jfruitet/RoBoNav/RoBoNav_Smartphone/Application MIT/Telecommande/assets/rc_right_2.png

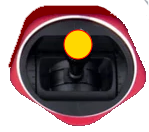
RoBoNav_Smartphone/Application MIT/Telecommande/assets/rc_right_2.png
