jfruitet/RoBoNav/RoBoNav_Smartphone/Application MIT/Telecommande/assets/rc_background.png

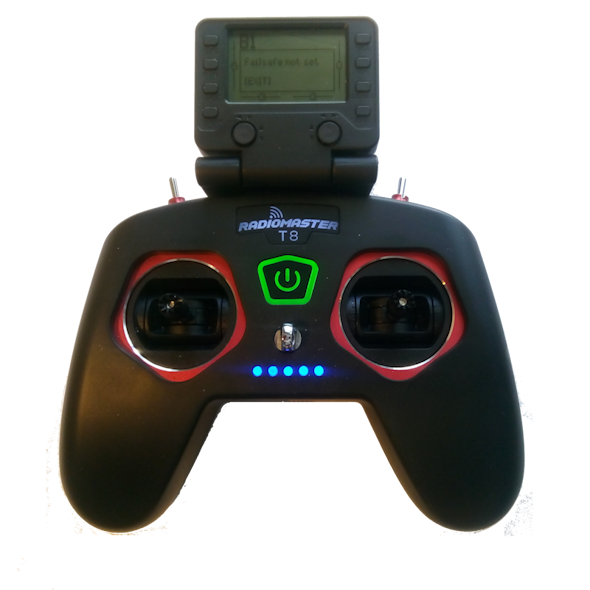
RoBoNav_Smartphone/Application MIT/Telecommande/assets/rc_background.png
