jfruitet/RoBoNav/RoBoNav_2025/README.md

# RoboNav

## Projet RoBoNav - 2025

Contributions de Agathe DAUDENTHUN <agathe.daudenthun@2026.icam.fr> et Thed KAMGA thed.kamga@2026.icam.fr de l'ICAM de Nantes

Contact : jean.fruitet@free.fr

## Présentation
En 2025 l'équipe de l'ICAM s'est consacrée à l'amélioration du positionnement GPS.

Différents GPS ont été utilisés, des GPS d'entrée de gamme UBlox M8N aux GPS Quectel RTK.
Des comparatifs de précision ont été effectués.

### RTK
Real Time Kinetic est un protocole permettant d'acquérir des données GPS de haute précision (de l'ordre du cm) 
La mise en oeuvre et une liste de matériel est disponible sur le site du réseau Centipede https://docs.centipede.fr/

Pour des raisons de coût nous nous sommes tournés vers des modules GPS Quectel de haute précision. 
Mais ce n'est qu'au mois de juillet 2025 que nous avons réussi à accéder à une précision centimétrique.

C'est l'équipe de développement 2025 - 2026 qui prendra en charge l'intégration au projet RoBoNav.

Pour accéder aux travaux concernant les GPS consulter le Github https://github.com/jfruitet/GPS
