jfruitet/RoBoNav/RoBoNav_Smartphone/Application MIT/MIT APP Inventor.docx

# APP MIT Inventor:

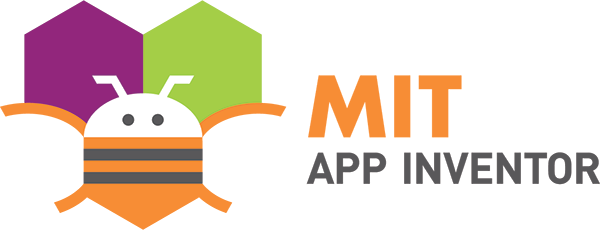
[picture p8: figure]

I. Introduction à MIT App inventor: 3

II. Mise en ligne d’une application MIT app inventor: 3

III. Page d'accueil 3

A. Screen 3

B. Blocs 4

IV. Télécommande 4

A. Screen: 4

B. Blocs: 5

1. Bloc d’initialisation: 5

2. Changement de l’adresse IP de la bouée: 6

3. Ajout du numéro de bouée à la fin de l’adresse IP, en fonction du choix de bouée 7

4. Contrôler l’envoie des données: 7

5. Envoie des blocs de caractères correspondant aux voies de la bouée: 7

6. Envoie des blocs de caractères correspondant au “Bouton ON” de la bouée: 8

7. Récupération des données du joystick et mise à l’échelle des valeurs: 9

8. Modélisation des switchs de la télécommande: 9

9. Récupération des données de la voies 1 à 4: 10

V. Map 12

A. Screen: 12

B. Blocs: 12

1. Initialisation des paramètres 13

2. Création d’un point GPS cible sur la carte: 13

3. Suppression d’un marqueur cible: 14

4. Gestion de l’adressage IP de la bouée: 15

5. Envoi du train de caractère pour récupérer le numéro de bouée et les coordonnées GPS de la bouée: 16

# I. Introduction à MIT App inventor:

Afin d’avoir une interface homme-machine, nous avons choisi de travailler avec MIT APP inventor, qui permet de créer de façon intuitive et efficace une application.

Voici le lien permettant de créer une application Androïd gratuitement et en ligne:

https://appinventor.mit.edu/

Cette application à un rôle de capteur. C’est à dire que lorsqu'un ordre à la bouée est donnée sous la forme d’une interaction avec l’application, l’application envoie à la bouée des “Blockchain” ou un train de chaîne de caractère à la bouée. Le traitement de ces informations se fait ensuite directement à travers la carte Arduino afin de transformer les ordres en action réalisé par la bouée.

Pour reconnaître quel type d’ordre provient de la bouée, nous avons mis des “mots clés”, en début de chaîne, ce qui nous permettra de repérer le type de chaîne envoyée.

# II. Mise en ligne d’une application MIT app inventor:

Vous retrouverez l'ensemble de la procédure de mise en ligne de l’application Androïd sur le lien suivant: https://fr.yeeply.com/blog/publier-application-google-play-store/

Pour résumer les étapes, il faut:

1. Créer une compte développeur sur google play (coût unique de 25 USD)
2. cliquer sur “toutes les applications” puis “créer une application”
3. Créer et remplir une liste Play Stores (avec les informations que les utilisateurs verront)
4. Télécharger le document apk de l’application et choisir le type de publication (test interne, fermé, ou ouvert)
5. Définir la classification du contenu de l’application (primordial car si non classifié, l’application pourrait être retiré)
6. Définir le prix et la distribution de votre application
7. Soumettre l’application à un examen (il faut attendre un contrôle vert sur chaque section)
8. Attendre que la version de déploiement soit disponible (cela peut prendre quelques jours)

# III. Page d'accueil

La page d’accueil a plus une fonction graphique que de commande de la bouée. Elle permet de présenter l’application et les personnes partenaires de l’application. Elle permet également de faire le lien avec la page où se trouve la télécommande et la page où se trouve la carte.

## A. Screen

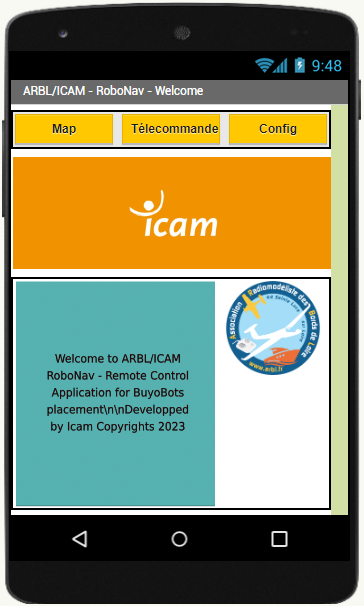
[picture p9: figure]

Btn_Config

Btn_Map

Btn_Télécommande

## B. Blocs

Cette fenêtre n’ayant pas beaucoup de fonctionnalités, peut de blocs y sont associés. Seuls les blocs de changement de screen existent. La screen 2 correspond à la page map.

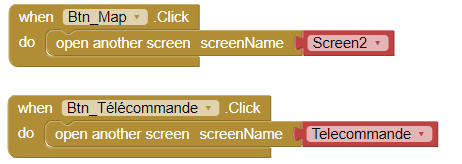
[picture p10: figure]

# IV. Télécommande

## A. Screen:

Voici à quoi ressemble l’interface de l’application sur l'écran télécommande. En légende sont inscrites toutes les appellations utilisées dans la partie des blocs.

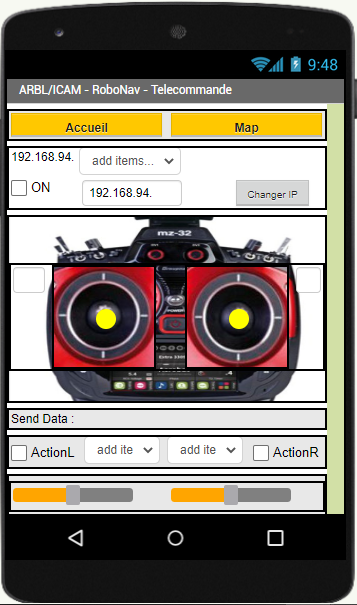
[picture p11: figure]

Btn_Map

Btn_Changer_IP

Btn_Accueil

Lbl_IP_bouee

Btn_ON

Txt_Box-New_IP

Spinner_IP_Bouee

Joy_Right

Joy_Left

Lbl_Send_Data

Lbl_UDP_Data

Action_L

Mode_L

Action_R

Mode_R

Voie3 & Voie4

Voie1 & Voie2

## B. Blocs:

### 1. Bloc d’initialisation:

Ce bloc à pour objectif d’initialiser toutes les variables lors du lancement de l’application, ou lors de l’ouverture de nouvelle fenêtre.

Tout d’abord nous initialisons toutes les variables globales:

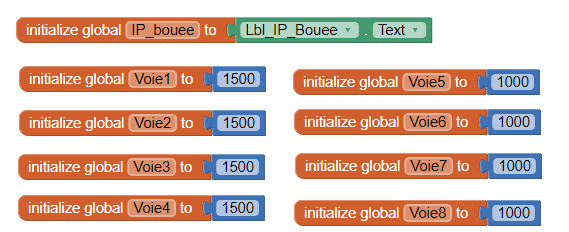
[picture p12: figure]

Chaque voie correspond à une voie physique d’une télécommande classique.

Puis nous initialisons les variables lié à la télécommande:

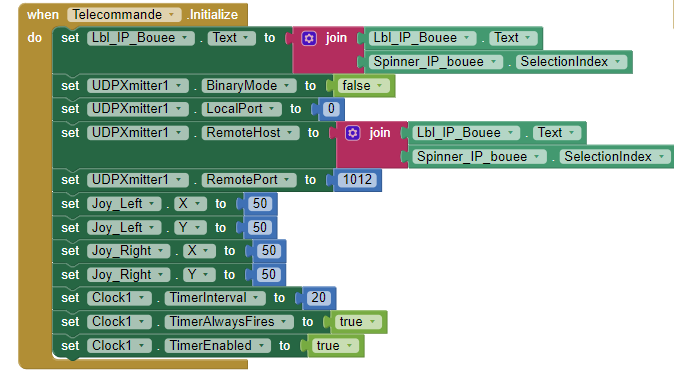
[picture p13: figure]

Initialisation du label de la bouée

Initialisation de L’UDPXmitter1 qui permet la transmission d’information de l’app vers la bouée

Initialisation des joysticks présents sur la télécommande

initialisation du timer permettant de contrôler la fréquence d'envoi des données

### 2. Changement de l’adresse IP de la bouée:

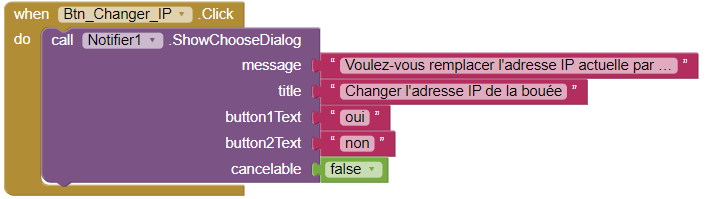
[picture p14: figure]

Lorsque l’on clique sur le bouton changer IP, alors un pop-up apparaît avec le texte du title et du message ainsi que 2 boutons: “oui”, “non”

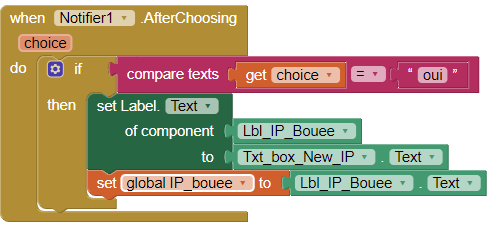
[picture p15: figure]

Si l’utilisateur choisit le cliqué sur oui, alors le bloc suivant permet de rentrer et dans le label et dans la variable IP_bouee la nouvelle adresse IP (texte qui était noté dans la Texte Box “Txt_box_Nex_IP”.

### 3. Ajout du numéro de bouée à la fin de l’adresse IP, en fonction du choix de bouée

Ce bloc permet que lorsque l’on change le numéro de bouée choisit dans le spinner, le numéro choisi vient s’ajouter à l’adresse IP préexistant.

!! Pour le moment les chiffres ne viennent pas se remplacer mais s’ajouter. Ainsi pour changer de numéro de bouée, il faut d’abord changer l’IP grâce au bouton, puis choisir le numéro de bouée.

### 4. Contrôler l’envoie des données:

Afin de contrôler l’envoie des données, et éviter la saturation des informations envoyées à la carte de programmation lors de l’utilisation de la télécommande présente sur l’application, nous avons utilisé une horloge (ou clock)

Voici le bloc associé à cette fonction:

### 5. Envoie des blocs de caractères correspondant aux voies de la bouée:

Pour pouvoir faire le lien entre l’application et la bouée, nous envoyons des trains de données grâce au protocole UDP.

Pour récupérer les données concernant RC1 (le mode 4 voies), voici le bloc utilisé:

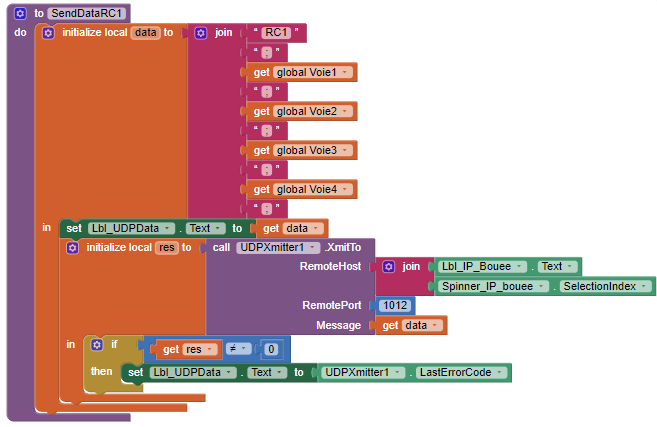
[picture p16: figure]

Le train de caractère commencera par RC1, afin que l’on puisse identifier sa source. Le séparateur choisis entre les différentes informations est un “:”. Seront mises en séries toutes les valeurs récupérés des voies 1 à 4.

Cette partie permet l’envoie des données selon le protocole UDP à l’IP de la bouée

De même, nous avons construit le même type de bloc pour RC2, mais cette fois-ci avec non pas 4 voies dans le haut du bloc, mais 8 voies.

### 6. Envoie des blocs de caractères correspondant au “Bouton ON” de la bouée:

Ces blocs correspondent à l’appelle de la fonction “SendDataON” lorsque le bouton est coché et décoché. Lorsque celui-ci est cohé, on attribue la valeur “true” à la variable globale “btn_ON_value”, et lorsque celui-ci est décocher, la valeur false.

La fonction “SendDataON” correspond à l’envoi du train de caractère à la carte programmable:

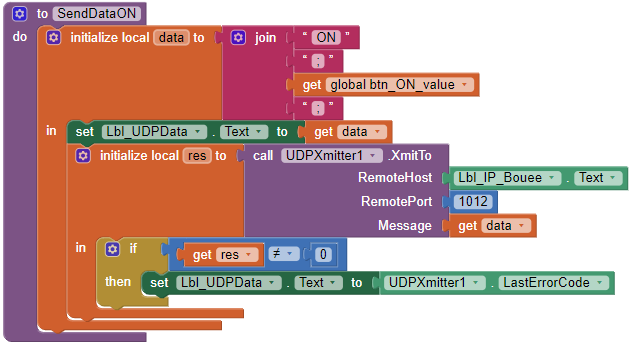
[picture p17: figure]

### 7. Récupération des données du joystick et mise à l’échelle des valeurs:

Les blocs ci-dessous correspondent aux blocs permettant de modéliser les joysticks de la télécommande. Vous ne trouverez que ceux pour le joystick de gauche. Cependant il existe exactement le même bloc pour le joystick droit.

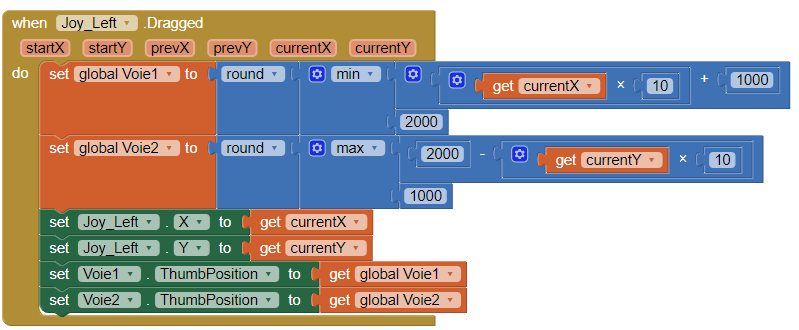
[picture p18: figure]
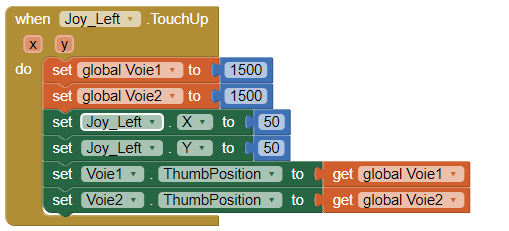
[picture p19: figure]

### 8. Modélisation des switchs de la télécommande:

Afin de modéliser les huits voies le la télécommande, nous avons rajouté des boutons “Action L” et “Action R” pour modéliser les switchs 2 positions, ainsi que des spinners “Mode L” et “Mode R” pour modéliser les switchs trois positions.

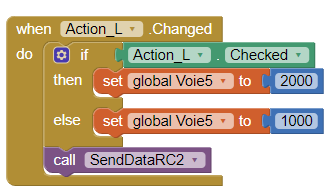
[picture p20: figure]

Bloc permettant que lorsque le Action_L est sélectionné, une valeur de 2000 est renvoyée sur la voie 5

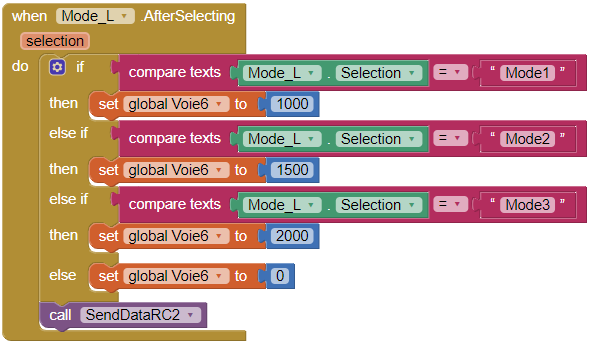
[picture p21: figure]

Ce bloc permet qu’en fonction de la sélection (Mode 1, 2, 3), les valeurs renvoyées sur la voie 6 soient différentes

### 9. Récupération des données de la voies 1 à 4:

Le rôle de l’application est de capter les ordres réalisés sur l'écran et de les transmettre à la bouée. Pour cela nous utilisons un protocole UDP, et envoyons les valeurs récupérées sur chaque vois sous forme d’un train de caractère. Voici le bloc permettant cet envoi.

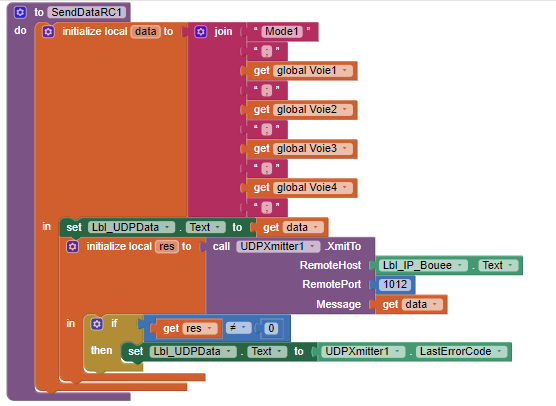
[picture p22: figure]

Formalisme d’envoi des données, avec pour séparateur de chaque donnée de chaque voie: un “;”

Protocole UDP d’envoi des données à la carte arduino par Wifi

10. Récupération des données de la voie 1 à 8:

Pour la récupération des 8 voies d’un seul coup, nous avons réalisé le même type de bloc que dans la partie ci-dessus, en ajoutant simplement les voies de 5 à 8 dans la première partie du bloc. Voici la partie concernée par le changement dans le bloc.

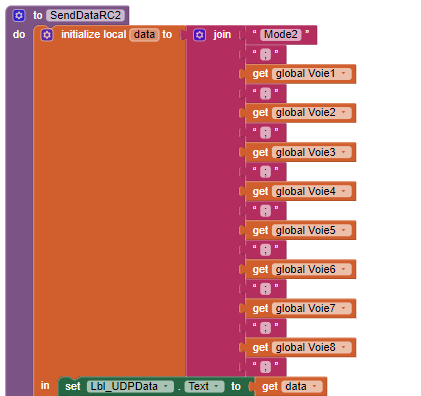
[picture p23: figure]

# V. Map

## A. Screen:

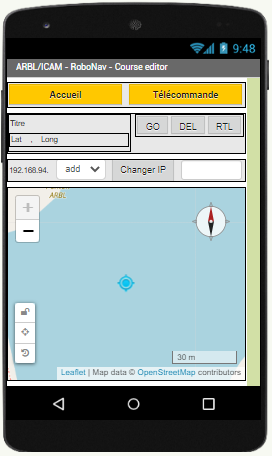
[picture p24: figure]

Btn_GO

Btn_DEL

BtnRTL

Btn_Télécommande

Btn_Accueil

Lbl_Cible

Lbl_Lat

Lbl_point

Lbl_Long

Lbl_IP_bouee

Spinner_IP_bouee

Btn_Changer_IP

Txt_Box_New_IP

Map_Zone

## B. Blocs:

### 1. Initialisation des paramètres

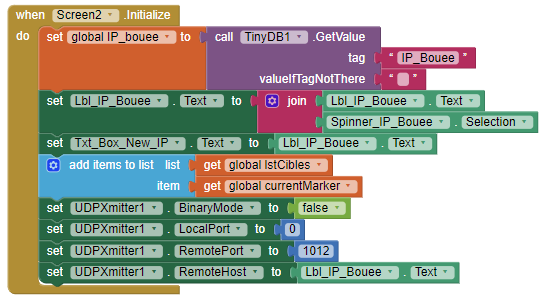
[picture p25: figure]

### 2. Création d’un point GPS cible sur la carte:

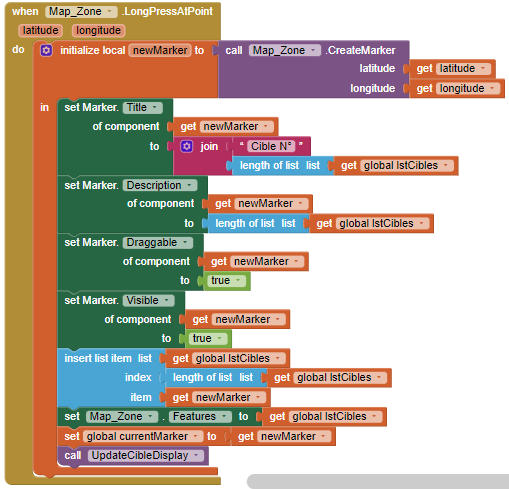
[picture p26: figure]

Création du marker

Association des paramètres (GPS et n° de bouée) au nouveau marker créé

Incrémentation du numéro de bouée en fonction du nombre de cible déjà créés

Ce bloc fait appel, à la fin, à la fonction “UpdateCibleDisplay”. La fonction est détaillée ci-dessous. Cette fonction permet de mettre à jour l’affichage des données concernant le numéro de cible, et les coordonnées GPS du marquer créé.

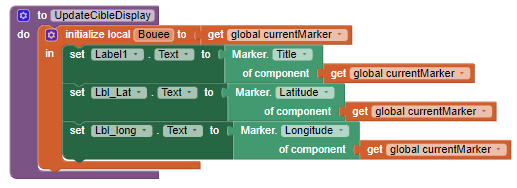
[picture p27: figure]

### 3. Suppression d’un marqueur cible:

Ce bloc permet que lorsque l’on appuis sur le bouton “DEL”, le marqueur sélectionné à ce moment-là est supprimé, et les données associées également.

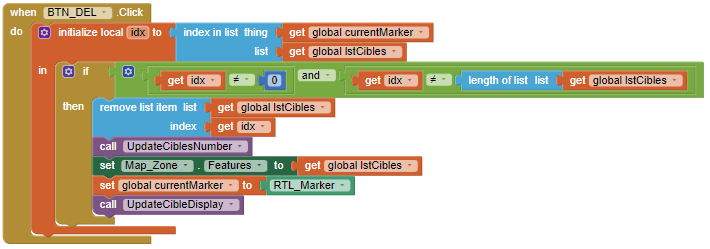
[picture p28: figure]

Ce bloc fait appelle à deux fonctions:

- UpdateCibleDisplay (déjà présenté ci-dessus)
- UdateCiblesNumber

Cette deuxième fonction permet d’ajouter un numéro de bouée, et donc une nouvelle cible dans la liste des bouées:

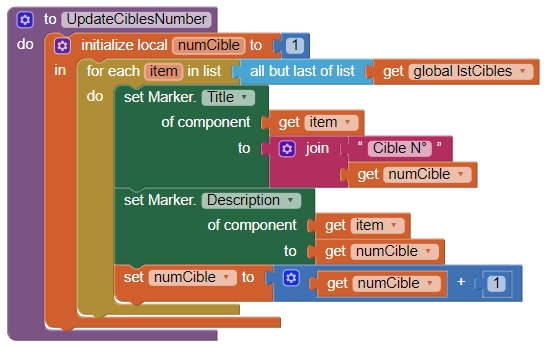
[picture p29: figure]

### 4. Gestion de l’adressage IP de la bouée:

Pour le changement d’adresse IP, nous avons procédé de la même manière que pour la télécommande, voici donc les blocs concernés:

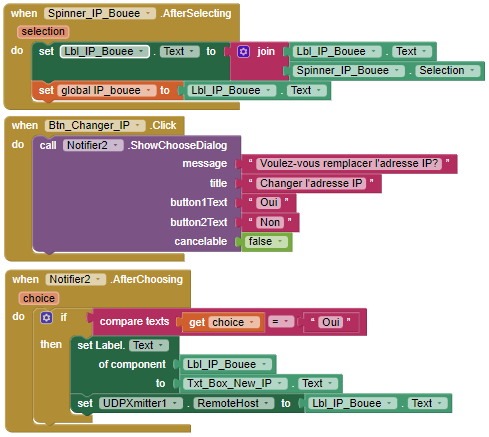
[picture p30: figure]

### 5. Envoi du train de caractère pour récupérer le numéro de bouée et les coordonnées GPS de la bouée:

Pour la réalisation la de l’envoi de train de caractère permettant de récupérer pour une bouée donnée les coordonnées (longitude et latitude) visés, nous avons utilisé deux blocs différents.

Tout d’abord nous avons fabriqué la fonction permettant de créer le train de caractère que nous souhaitons envoyer. Nous avons choisi le mot “GPS” comme mot repère du bloc, qui nous permettra ainsi d’identifier la réception d’un bloc possédant les coordonnées visées de la bouée lors du traitement des blocs dans la partie Arduino.

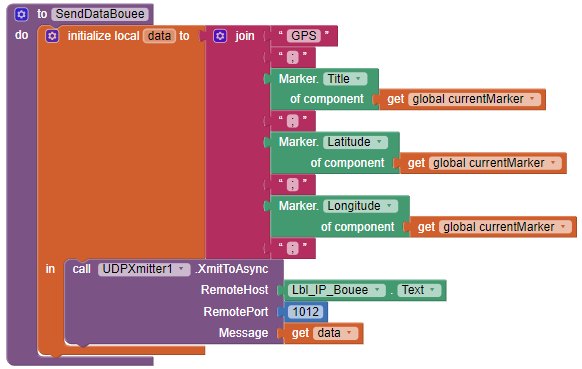
[picture p31: figure]

Partie concernant la création du train de caractère, séparé par des “;”

Liaison avec la bouée par un protocole UDP

Puis nous avons réalisé les conditions d’appel de la fonction:

Lorsque le Bouton Go est cliqué, alors les coordonnées de la cible sélectionnée sont envoyées au récepteur wifi arduino.

FREMY Enora et LOUVET Marie
