jfruitet/RoBoNav/RoBoNav_PCB/dimensions PCB.jpg

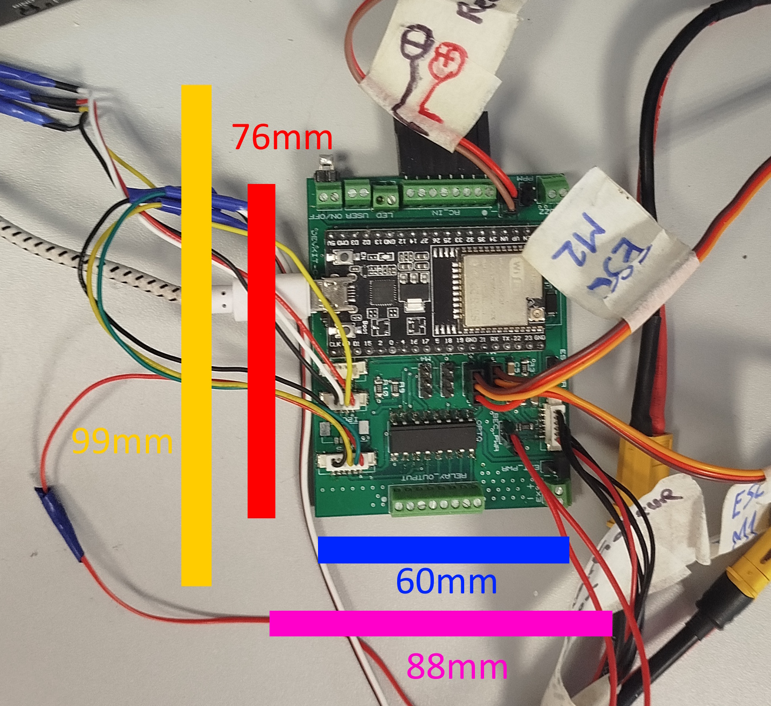
RoBoNav_PCB/dimensions PCB.jpg
