jfruitet/RoBoNav/RoBoNav_PCB/Schematic_Board_v0.7.png

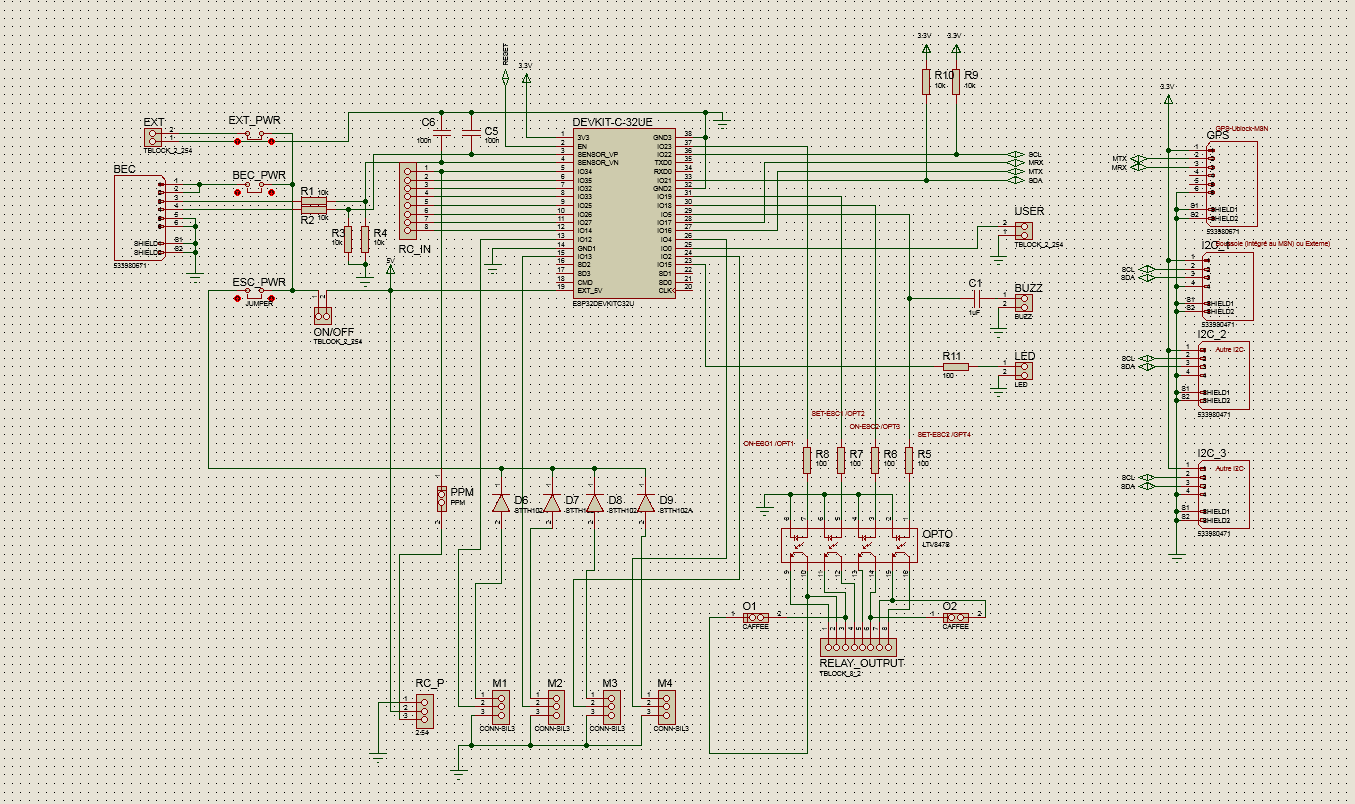
RoBoNav_PCB/Schematic_Board_v0.7.png
