jfruitet/RoBoNav/RoBoNav_Smartphone/Application MIT/Telecommande/assets/AccueilMap.png

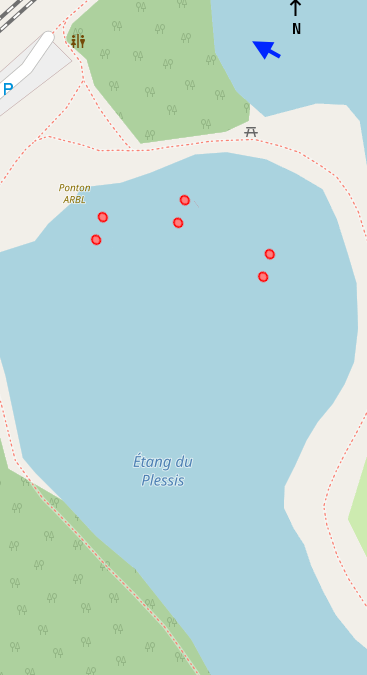
RoBoNav_Smartphone/Application MIT/Telecommande/assets/AccueilMap.png
