jfruitet/RoBoNav/RoBoNav_Smartphone/Application MIT/Telecommande/assets/ICAM.jpg

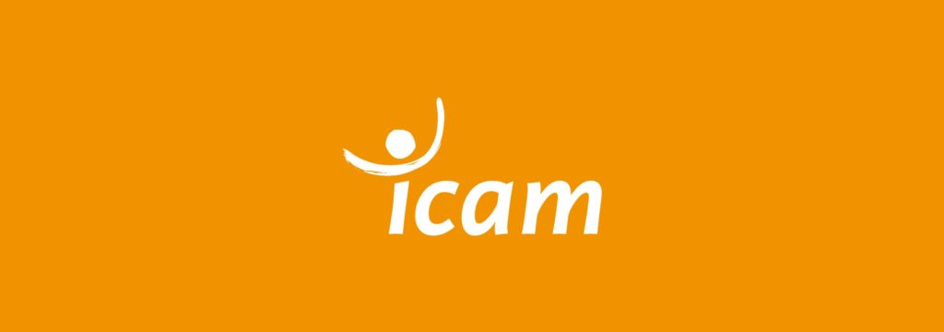
RoBoNav_Smartphone/Application MIT/Telecommande/assets/ICAM.jpg
