jfruitet/RoBoNav/RoBoNav_Smartphone/Application MIT/Telecommande/assets/ICAM.png

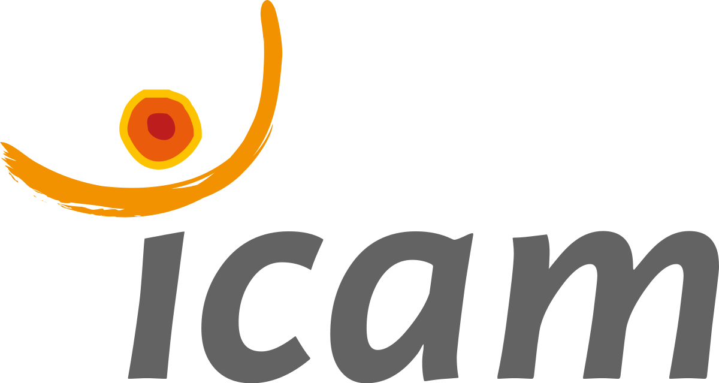
RoBoNav_Smartphone/Application MIT/Telecommande/assets/ICAM.png
