jfruitet/RoBoNav/RoBoNav_Smartphone/Application MIT/Telecommande/assets/IMG_20230528_100340.jpg

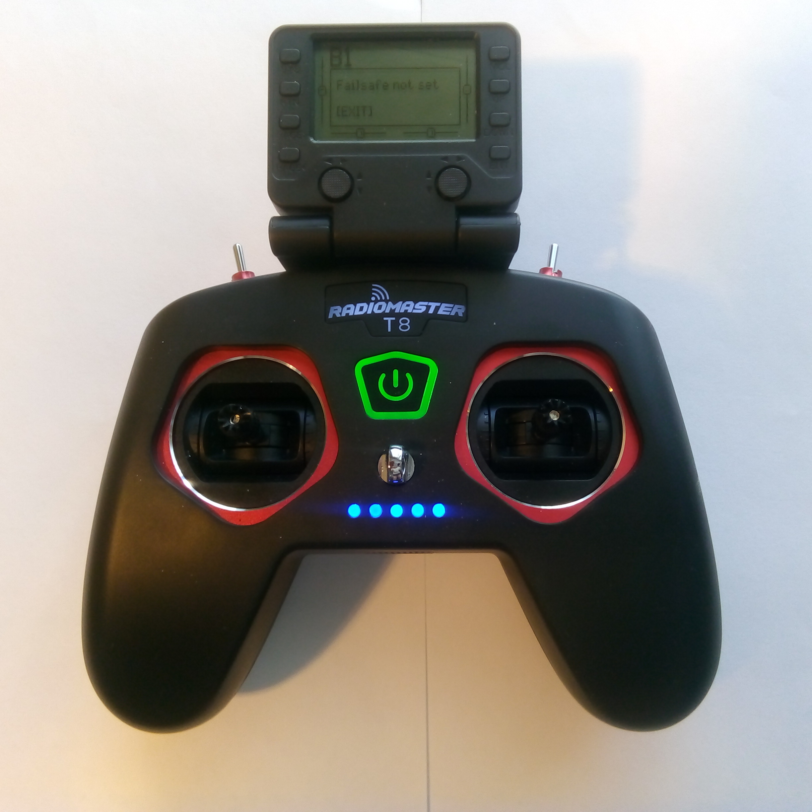
RoBoNav_Smartphone/Application MIT/Telecommande/assets/IMG_20230528_100340.jpg
