jfruitet/RoBoNav/RoBoNav_Smartphone/Application MIT/Telecommande/assets/Messageacceuil.PNG

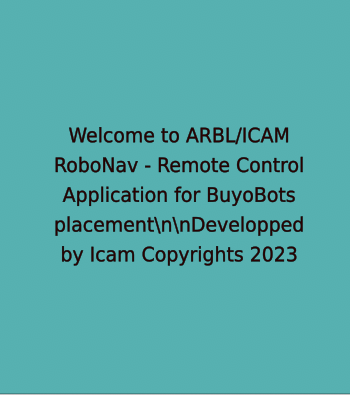
RoBoNav_Smartphone/Application MIT/Telecommande/assets/Messageacceuil.PNG
