jfruitet/RoBoNav/RoBoNav_Smartphone/Application MIT/Telecommande/assets/Messageaccueil.png

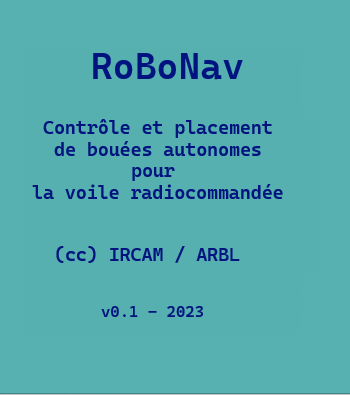
RoBoNav_Smartphone/Application MIT/Telecommande/assets/Messageaccueil.png
