jfruitet/RoBoNav/RoBoNav_Smartphone/Application MIT/Telecommande/assets/rc_background.jpg

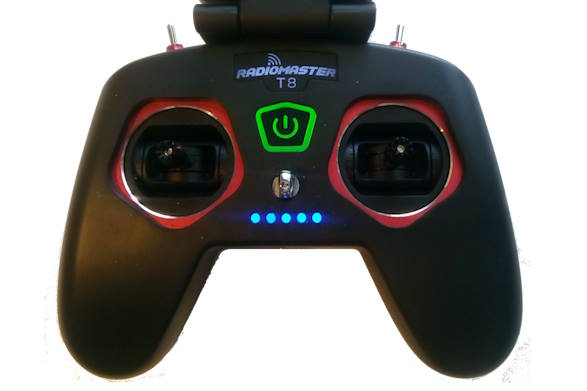
RoBoNav_Smartphone/Application MIT/Telecommande/assets/rc_background.jpg
