jfruitet/RoBoNav/RoBoNav_Smartphone/Application MIT/Telecommande/assets/rc_background_graupner.jpg

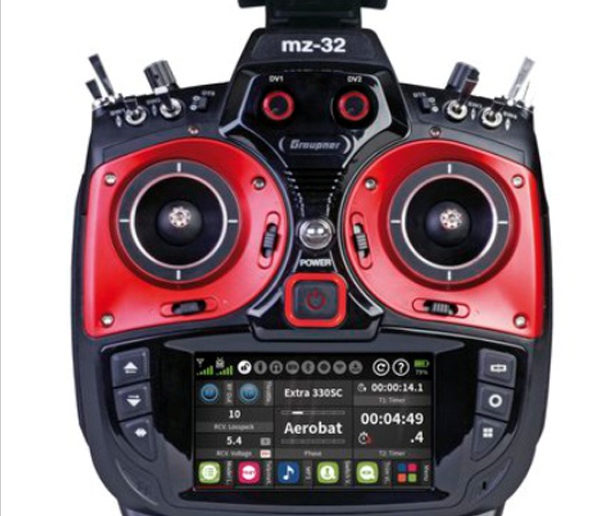
RoBoNav_Smartphone/Application MIT/Telecommande/assets/rc_background_graupner.jpg
