jfruitet/RoBoNav/RoBoNav_Smartphone/Application MIT/Telecommande/assets/rc_left_2.png

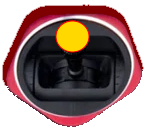
RoBoNav_Smartphone/Application MIT/Telecommande/assets/rc_left_2.png
