jfruitet/RoBoNav/RoBoNav_Smartphone/Application MIT/Telecommande/assets/rc_left_graupner.png

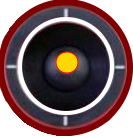
RoBoNav_Smartphone/Application MIT/Telecommande/assets/rc_left_graupner.png
