jfruitet/RoBoNav/RoBoNav_Smartphone/Application MIT/Telecommande/assets/Test/Accueil_simulateur.png

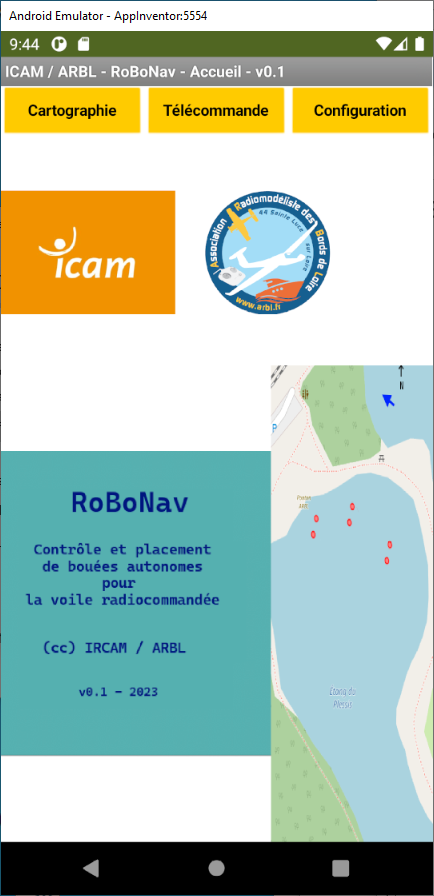
RoBoNav_Smartphone/Application MIT/Telecommande/assets/Test/Accueil_simulateur.png
