jfruitet/RoBoNav/RoBoNav_PCB/RoboNav7_PCB_Schema_cablage.PDF

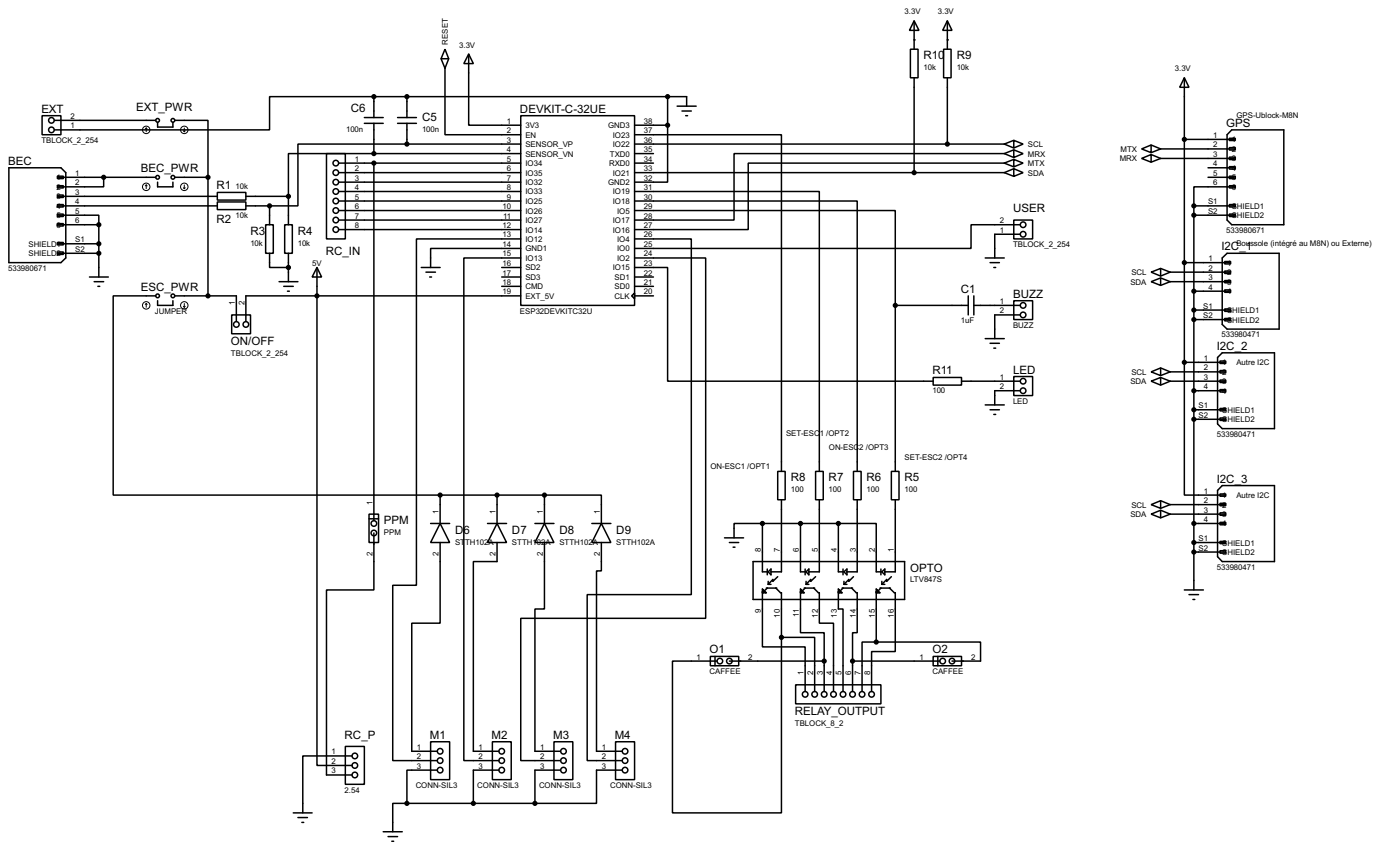
[picture p73: page 1]

33
32

30
29
28
27
26

14 | | 25
15 | | 24
