jfruitet/RoBoNav/(list of files, drawings)

Other design files:
RoBoNav_PCB/RobotNav7.pdsprj
RoBoNav_PCB/RobotNav.pdsprj
