jfruitet/RoBoNav/RoBoNav_ESP32/src/RoBoNav_config_WiFi.h

/*******************************************
RoBoNav  2023 - 2024 - RoBoNav_config_WiFi.h 

********************************************/

#ifndef RoBoNav_config_WiFi_H
#define RoBoNav_config_WiFi_H

//--- WiFi Access Point Configuration ---//
const char *ssid = "NicoPhone";
const char *password = "12345678";

#endif
