jfruitet/RoBoNav/r4_BLE_UART_CommandeDirection/flechesdirection2.h

#define leftDir  3
#define rightDir  2
#define upDir  1
#define downDir  0
#define questionDir  4

const uint32_t flechesdirection2[][4] = {
	{
		0x4004004,
		0x401f00,
		0xe0040000,
		66
	},
	{
		0x400e,
		0x1f00400,
		0x40040040,
		66
	},
	{
		0x1001,
		0x81fc0180,
		0x10000000,
		66
	},
	{
		0x400c,
		0x1fc0c00,
		0x40000000,
		66
	},
	{
		0xe011,
		0x1100600,
		0x40000040,
		66
	}
};
