jfruitet/RoBoNav/(commit log)

2024-07-18 Schémas du circuit imprimé et brochage pour ESP32-WROOM
    [RobotNav [20240314, 16-56-37].pdsprj, RobotNav [20240314, 16-57-49].pdsprj, RobotNav [20240314, 16-59-04].pdsprj, RobotNav [20240314, 16-59-47].pdsprj, RobotNav [20240314, 17-01-59].pdsprj, RobotNav [20240314, 17-02-48].pdsprj, RobotNav [20240314, 17-03-42].pdsprj, RobotNav [20240325, 17-43-15].pdsprj]
2024-07-19 supression des versions antérieures à la V7 de la carte
    [RobotNav [20240314, 16-56-37].pdsprj, RobotNav [20240314, 16-57-49].pdsprj, RobotNav [20240314, 16-59-04].pdsprj, RobotNav [20240314, 16-59-47].pdsprj, RobotNav [20240314, 17-01-59].pdsprj, RobotNav [20240314, 17-02-48].pdsprj, RobotNav [20240314, 17-03-42].pdsprj, RobotNav [20240325, 17-43-15].pdsprj]
2024-07-19 Suppression des backups Prometeus Signed-off-by: Jean FRUITET <jean.fruitet@free.fr>
    [RobotNav [20240314, 16-56-37].pdsprj, RobotNav [20240314, 16-57-49].pdsprj, RobotNav [20240314, 16-59-04].pdsprj, RobotNav [20240314, 16-59-47].pdsprj, RobotNav [20240314, 17-01-59].pdsprj, RobotNav [20240314, 17-02-48].pdsprj, RobotNav [20240314, 17-03-42].pdsprj, RobotNav [20240325, 17-43-15].pdsprj]
2024-07-19 Mise à jour de la licence MIT
2024-08-16 Developpement à base de Arduino Uno WiFi BlueTooth
2025-04-03 Update README.md
    Ajout de planning 2025
2025-06-25 Sources commentées en détail
    Pour me rendre la lecture plus facile
2025-09-10 Présentation des documents
    Liste de liens vers les ressources RoBoNav
2025-09-10 Create RessourcesRoBoNav.pdf
    Liste de liens et documentation
2025-09-19 Ajout schéma de câblage et suppression des .zip
2025-09-21 Tests
    Outils pour la réalisation de test de consommation et de dérive
2025-09-22 Entêtes des sources commentées
    Rédaction de commentaires en entête de fichiers .
    Pour faciliter l'impression des sources le nom du fichier a été ajouté .
2025-09-22 MàJ septembre 2025
    Actualisation du README.md pour prendre en compte les nouveaux contributeurs
2025-11-06 Doc complétée
    Précision concernant le cahier des charges des tests.
