jfruitet/RoBoNav/(notices)

Notices in the files:
HMC5883L/HMC5883L.cpp:
This program is free software: you can redistribute it and/or modify
it under the terms of the version 3 GNU General Public License as
published by the Free Software Foundation.
